mengstr/BEEPoo/README.md

## BEEPoo - Standalone AY3-8912 sound player

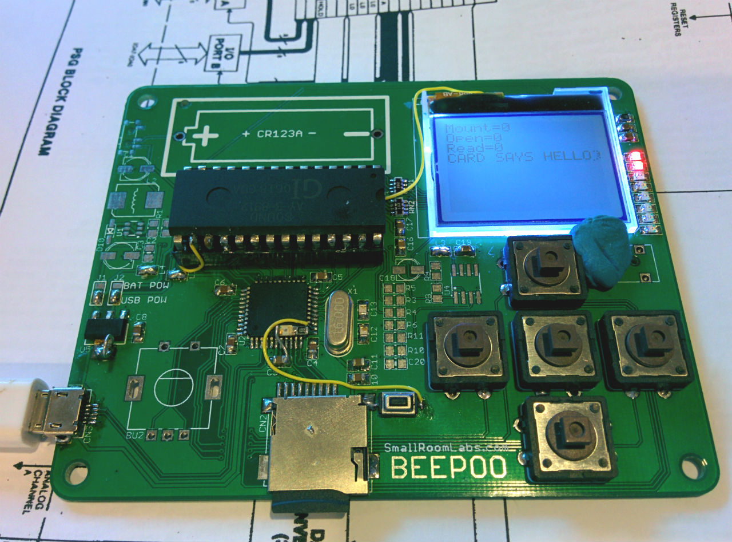
[picture p1: Misc/beepoo-devel1.jpg]
