mengstr/BEEPoo/Eagle/Beepoo.brd

## EAGLE design Eagle/Beepoo.brd (2014-11-11)

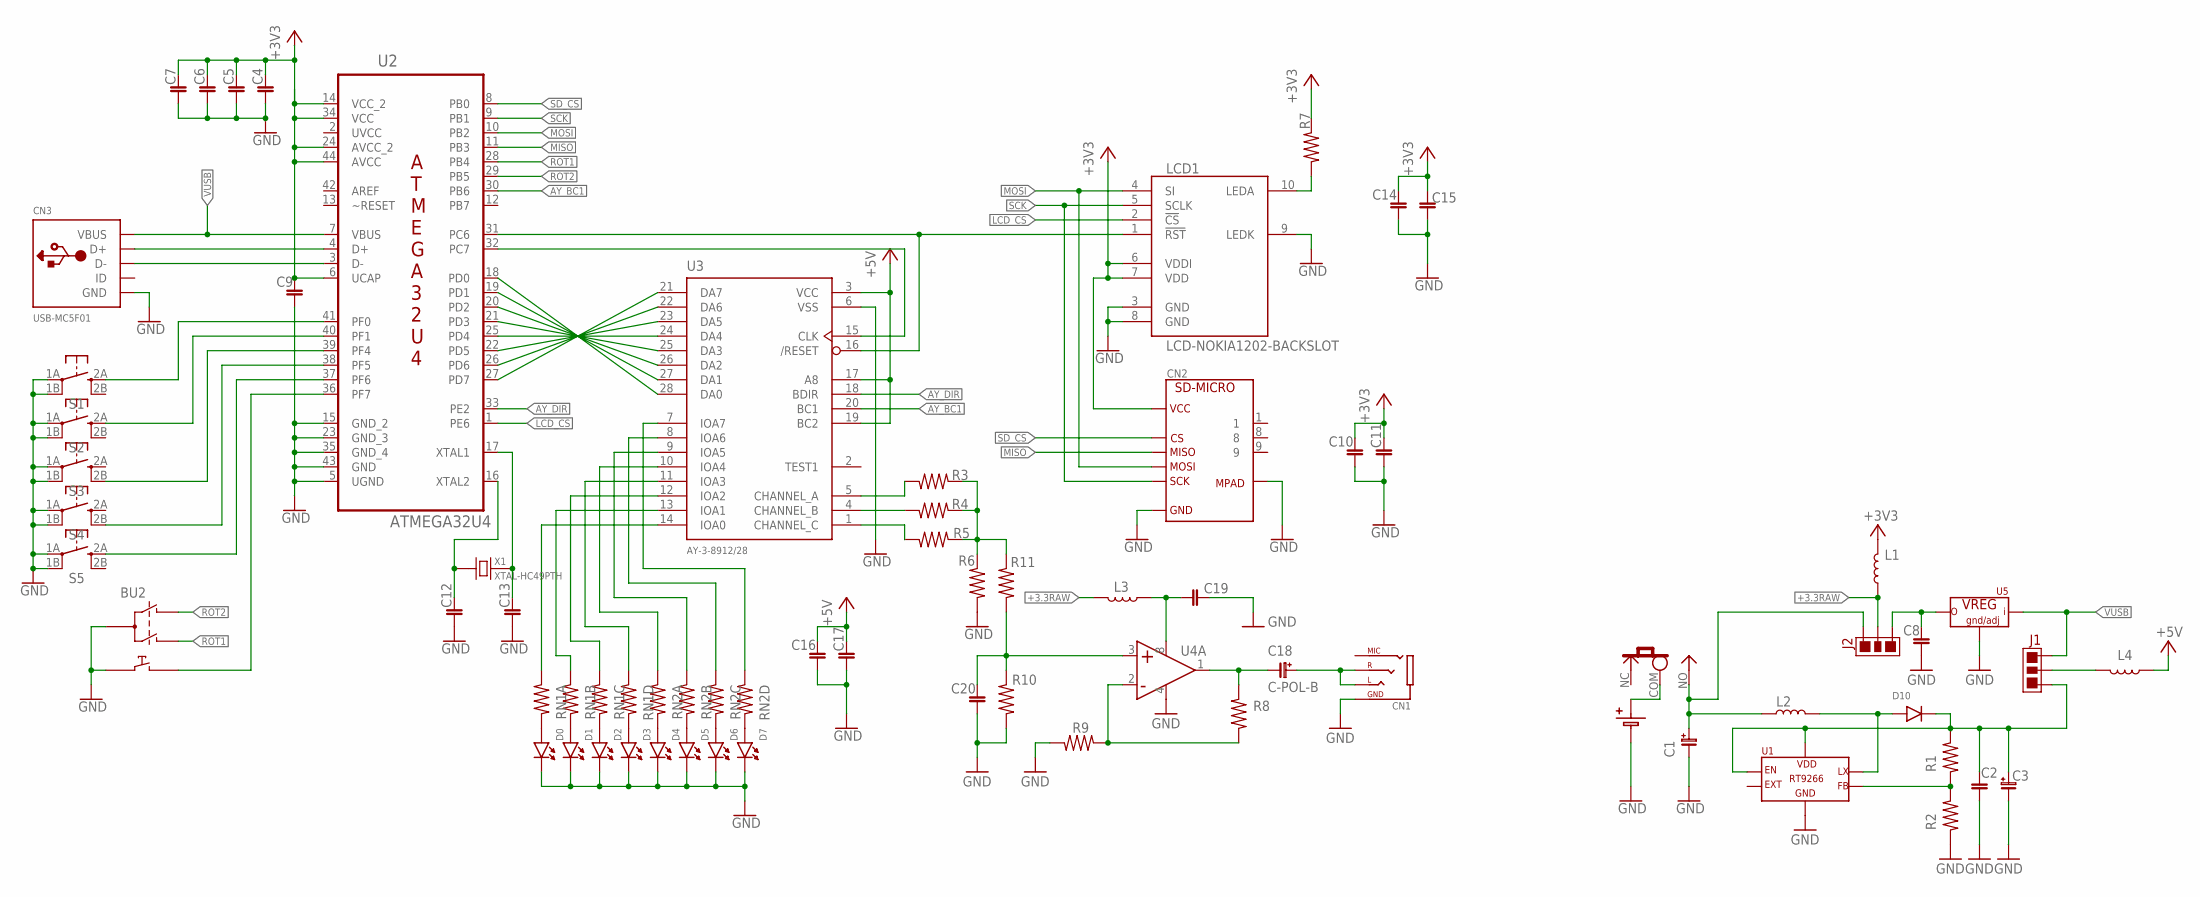
[picture p2: schematic Beepoo.sch]

Parts:
BA1: BATTERY2-CR123; BAT-CR123A
BU2: ROTARY
C1: C-POL-C; PANASONIC_C
C2, C4, C5, C6, C7, C11, C12, C13, C15, C17, C20: C-0805; C0805
C3: EEEFK0J101UR; PANASONIC_C
C8, C9, C10, C14, C16, C19: 1u; C0805
C18: C-POL-B; PANASONIC_B
CN1: JACK4PTH; PJ320E
CN2: SD-MICRO; SD-TFP09
CN3: USB-MC5F01; USB-MICRO-MC5F01
D0, D1, D2, D3, D4, D5, D6, D7: LED-0805; LED0805
D10: DIODE-SOD123; SOD123
J1, J2: JUMPER3-1.5MM; JP3-1.5MM
L1, L3, L4: L-0805; L0805
L2: L-BOURNS-SRP7030; IND-BOURNS-SRP7030
LCD1: LCD-NOKIA1202-BACKSLOT; NOKIA1202LCD-BACK-SLOT
R1, R2, R3, R4, R5, R6, R7, R8, R9, R10, R11: R-0805; R0805
RN1, RN2: R-ARR4; RN8P-4R-CRA06S
S1, S2, S3, S4, S5: SWITCH2-12X12PTH; TACT12X12-PTH
SW2: SLIDE1-PCM12; SW-PCM12
U1: RT9266-SOT23; SOT23-6
U2: ATMEGA32U4; TQFP44
U3: AY-3-8912/28; DIL28-6
U4: OPAMP-DUAL-SOIC8; SO08
U5: VREG3-SOT223; SOT223
X1: XTAL-HC49PTH; HC49US

Connections:
+3.3RAW: J2.P$2, L1.1, L3.2
+3V3: C4.2, C5.2, C6.2, C7.2, C9.2, C10.2, C11.2, C14.2, C15.2, CN2.4, L1.2, LCD1.6 (VDDI), LCD1.7 (VDD), R7.1, U2.6 (UCAP), U2.14 (VCC_2), U2.24 (AVCC_2), U2.34 (VCC), U2.44 (AVCC)
+5V: C16.2, C17.2, L4.1, U3.3 (VCC), U3.17 (A8), U3.19 (BC2)
AY_BC1: U2.30 (PB6), U3.20 (BC1)
AY_CLK: U2.32 (PC7), U3.15 (CLK)
AY_DIR: U2.33 (PE2), U3.18 (BDIR)
AY_RESET: LCD1.1 (!RST), U2.31 (PC6), U3.16 (/RESET)
BAT: BA1.POS (POS1), SW2.COM
BAT-SWITCHED: C1.+ (A), J2.P$1, L2.P$1, SW2.NO
GND: BA1.NEG, BU2.Q, BU2.SW1, C1.- (C), C2.2, C3.- (C), C4.1, C5.1, C6.1, C7.1, C8.1, C9.1, C10.1, C11.1, C12.1, C13.1, C14.1, C15.1, C16.1, C17.1, C19.2, C20.1, CN1.G (GND), CN2.GND@1, CN2.GND@2, CN3.P5 (GND), D0.C, D1.C, D2.C, D3.C, D4.C, D5.C, D6.C, D7.C, LCD1.3 (GND), LCD1.8 (GND), LCD1.9 (LEDK), R2.1, R6.2, R9.2, R10.2, S1.1A, S1.1B, S2.1A, S2.1B, S3.1A, S3.1B, S4.1A, S4.1B, S5.1A, S5.1B, U1.3 (GND), U2.5 (UGND), U2.15 (GND_2), U2.23 (GND_3), U2.35 (GND_4), U2.43 (GND), U3.6 (VSS), U4.4 (V-), U5.1 (G/A)
LCD_CS: LCD1.2 (!CS), U2.1 (PE6)
MISO: CN2.7, U2.11 (PB3)
MOSI: CN2.3, LCD1.4 (SI), U2.10 (PB2)
unnamed: D10.A, L2.P$2, U1.4 (LX)
unnamed: C18.+ (A), CN1.L, CN1.R
unnamed: R1.1, R2.2, U1.6 (FB)
unnamed: U2.27 (PD7), U3.21 (DA7)
unnamed: U2.26 (PD6), U3.22 (DA6)
unnamed: U2.22 (PD5), U3.23 (DA5)
unnamed: U2.25 (PD4), U3.24 (DA4)
unnamed: U2.21 (PD3), U3.25 (DA3)
unnamed: U2.20 (PD2), U3.26 (DA2)
unnamed: U2.19 (PD1), U3.27 (DA1)
unnamed: U2.18 (PD0), U3.28 (DA0)
unnamed: C8.2, J2.P$3, U5.2 (OUT), U5.4 (OUT)
unnamed: CN3.P3 (D+), U2.4 (D+)
unnamed: CN3.P2 (D-), U2.3 (D-)
unnamed: C2.1, C3.+ (A), D10.C, J1.P$3, R1.2, U1.1 (EN), U1.5 (VDD)
unnamed: D0.A, RN1.8
unnamed: D1.A, RN1.7
unnamed: D2.A, RN1.6
unnamed: D3.A, RN1.5
unnamed: D4.A, RN2.8
unnamed: C12.2, U2.16 (XTAL2), X1.1
unnamed: D5.A, RN2.7
unnamed: D7.A, RN2.5
unnamed: D6.A, RN2.6
unnamed: RN2.4, U3.7 (IOA7)
unnamed: RN2.3, U3.8 (IOA6)
unnamed: RN2.2, U3.9 (IOA5)
unnamed: RN2.1, U3.10 (IOA4)
unnamed: RN1.4, U3.11 (IOA3)
unnamed: RN1.3, U3.12 (IOA2)
unnamed: RN1.2, U3.13 (IOA1)
unnamed: RN1.1, U3.14 (IOA0)
unnamed: R3.2, U3.5 (CHANNEL_A)
unnamed: R4.2, U3.4 (CHANNEL_B)
unnamed: R5.2, U3.1 (CHANNEL_C)
unnamed: S1.2A, U2.41 (PF0)
unnamed: S2.2A, U2.40 (PF1)
unnamed: S3.2B, U2.39 (PF4)
unnamed: S4.2B, U2.38 (PF5)
unnamed: S5.2A, U2.37 (PF6)
unnamed: R3.1, R4.1, R5.1, R6.1, R11.1
unnamed: BU2.SW2, U2.36 (PF7)
unnamed: C13.2, U2.17 (XTAL1), X1.2
unnamed: LCD1.10 (LEDA), R7.2
unnamed: C18.- (C), R8.1, U4.1 (OUT)
unnamed: C19.1, L3.1, U4.8 (V+)
unnamed: R8.2, R9.1, U4.2 (NEG)
unnamed: J1.P$2, L4.2
unnamed: C20.2, R10.1, R11.2, U4.3 (POS)
ROT1: BU2.Q2, U2.28 (PB4)
ROT2: BU2.Q1, U2.29 (PB5)
SCK: CN2.5, LCD1.5 (SCLK), U2.9 (PB1)
SD_CS: CN2.2, U2.8 (PB0)
UVCC: U2.2 (UVCC)
VUSB: CN3.P1 (VBUS), J1.P$1, U2.7 (VBUS), U5.3 (IN)

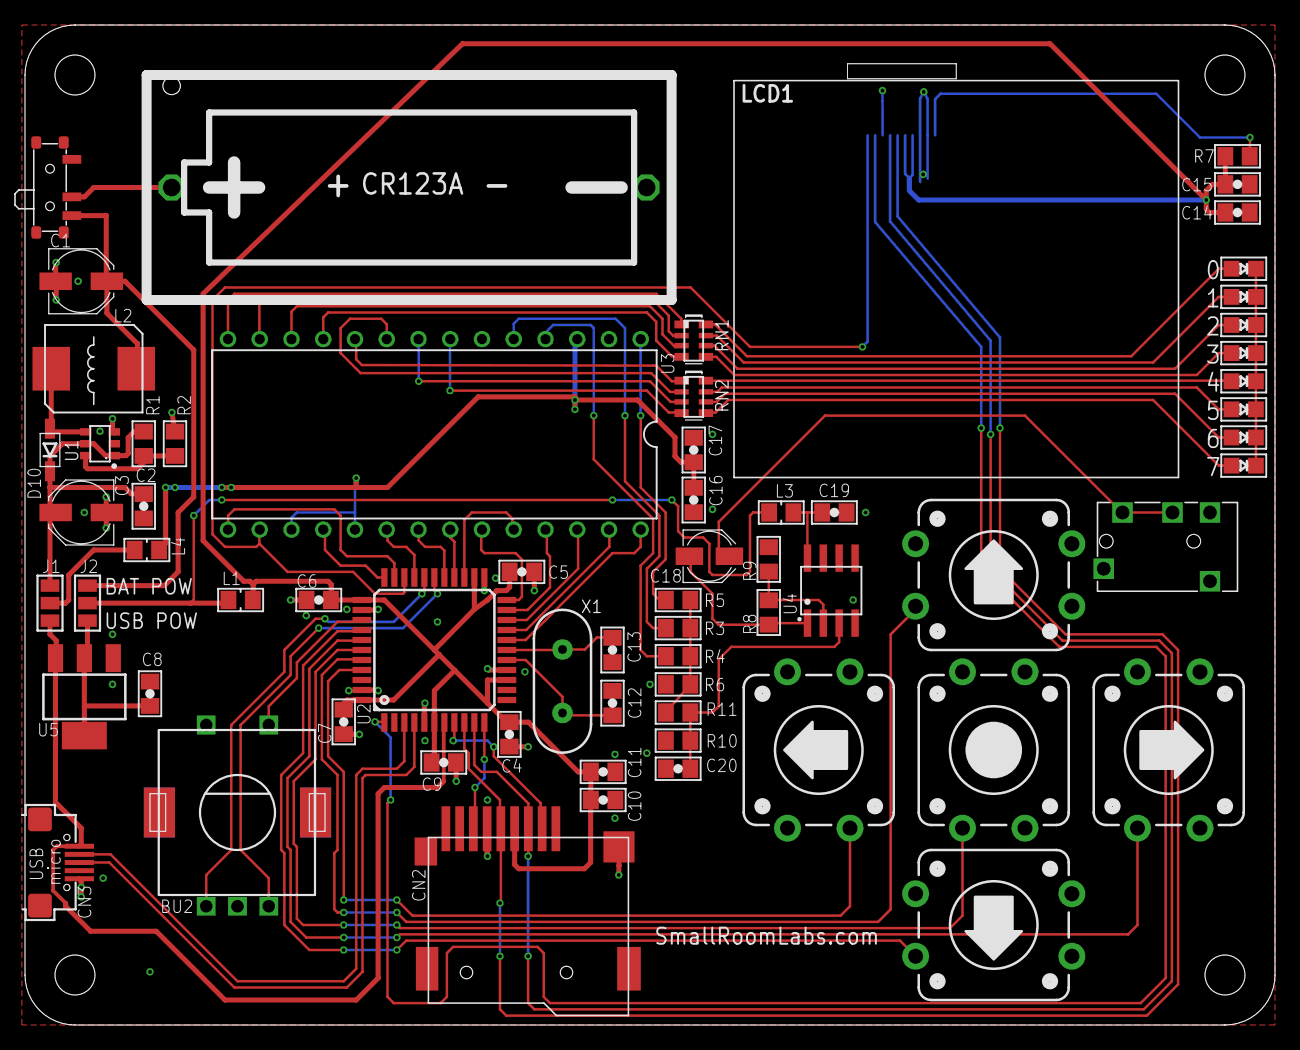
[picture p3: board Beepoo.brd from above]

Board: 2 copper layers, 100.0 x 80.0 mm, 66 parts (0 on the bottom side), 67 nets.
