mengstr/BEEPoo/Firmware/BEEPoo/BEEPoo.ino

//
// BEEPoo - Standalone AY-3-8912 player with ATMEGA32U4 with Arduino bootloader
//
// Copyright (c) 2014 SmallRoomLabs / Mats Engstrom - mats.engstrom@gmail.com
// 
// Hardware and Firmware released under the MIT License (MIT) than can be
// found in full in the file named LICENCE in the git repository.
//
// https://github.com/SmallRoomLabs/BEEPoo
//

//
//   PB0 SD_CS       RXLED
//   PB1 SCK         SCK
//   PB2 MOSI        MOSI
//   PB3 MISO        MISO
//   PB4 Rotary Q1   Digital pin 8  (PCINT4)
//   PB5 Rotary Q2   Digital Pin 9 (PCINT5) (PWM)
//   PB6 AY_BC1      Digital Pin 10 (PWM)
//   PB7             Digital pin 11 (PWM)
//   
//   PC6 AY_RESET#   Digital Pin 5 (PWM)
//   PC7 AY_CLK      Digital Pin 13 (PWM)
//   
//   PD0 AY_Data0    Digital pin 3 (SCL)(PWM)
//   PD1 AY_Data1    Digital pin 2 (SDA)
//   PD2 AY_Data2    Digital pin 0 (RX)
//   PD3 AY_Data3    Digital pin 1 (TX)
//   PD4 AY_Data4    Digital pin 4
//   PD5 AY_Data5    TXLED
//   PD6 AY_Data6    Digital pin 12
//   PD7 AY_Data7    Digital Pin 6 (PWM)
// 
//   PE2 AY_Dir      HWB
//   PE6 LCD_CS      Digital pin 7
//   
//   PF0 Button      Analog In 5
//   PF1 Button      Analog In 4
//   PF4 Button      Analog In 3
//   PF5 Button      Analog In 2
//   PF6 Button      Analog In 1
//   PF7 Rotary But  Analog In 0
// 
// 

#include <stdint.h>
#include "rotary.h"
#include "spi.h"
#include "timer1.h"
#include "timer4.h"
#include "ay38912.h"
#include "nokia1202.h"
#include "pff.h"
#include "selectFile.h"
#include "ymplayer.h"
#include "buttons.h"

int AY_RESET    = 5;        // D5
int AY_CLK      = 13;       // D13
int AY_BC1      = 10;       // D10
int DEBUG_LED   = 11;       // D11

#define DEBUGLED_ON  PORTB |= B10000000
#define DEBUGLED_OFF PORTB &= B01111111


//
//
//
void setup() {
  uint8_t mask;

  // PB0 o SD_CS       RXLED
  // PB1 o SCK         SCK
  // PB2 o MOSI        MOSI
  // PB3 i MISO        MISO
  // PB4 i Rotary Q1   Digital pin 8 
  // PB5 i Rotary Q2   Digital Pin 9 (PWM)
  // PB6 o AY_BC1      Digital Pin 10 (PWM)
  // PB7 o DEBUGLED    Digital pin 11 (PWM)
  DDRB=0x00 | (1<<0) | (1<<1) | (1<<2) | (1<<6) | (1<<7);
  // Enable pullup on Rotary Q1/Q3 & MISO
  PORTB=0x00 | (1<<3) | (1<<4) | (1<<5);  

  // PC6 o AY_RESET#   Digital Pin 5 (PWM)
  // PC7 o AY_CLK      Digital Pin 13 (PWM)
  DDRC=0x00 | (1<<6) | (1<<7);
  PORTC=0x00;

  // PD0 o AY_Data0    Digital pin 3 (SCL)(PWM)
  // PD1 o AY_Data1    Digital pin 2 (SDA)
  // PD2 o AY_Data2    Digital pin 0 (RX)
  // PD3 o AY_Data3    Digital pin 1 (TX)
  // PD4 o AY_Data4    Digital pin 4
  // PD5 o AY_Data5    TXLED
  // PD6 o AY_Data6    Digital pin 12
  // PD7 o AY_Data7    Digital Pin 6 (PWM)
  DDRD=0xFF;
  PORTD=0x00;

  // PE2 o AY_Dir      HWB
  // PE6 o LCD_CS      Digital pin 7
  DDRE=0x00 | (1<<2) | (1<<6);
  PORTE=0x00;  

  // PF0 i Button      Analog In 5
  // PF1 i Button      Analog In 4
  // PF4 i Button      Analog In 3
  // PF5 i Button      Analog In 2
  // PF6 i Button      Analog In 1
  // PF7 i Rotary But  Analog In 0
  DDRF=0x00;
  // Enable pullup on all Buttons & Rotary Button
  PORTF=0x00 | (1<<0) | (1<<1) | (1<<4) | (1<<5) | (1<<6) | (1<<7);  

  // Reset AY389-10
  digitalWrite(AY_RESET,LOW);

 // Start timer4 output to D13
  InitTimer4(1000000);
  SetTimer4Duty(512);
  Timer4Start();
  
  // Delay 1 ms before bringing AY out of reset
  delay(1);    
  digitalWrite(AY_RESET,HIGH);

  // Enable PORT A, and the thre tone channels on the AY-3-8912 
  // and turn off all leds
  AyRegister(AY_ENABLE,B01111000);
  for (mask=0x01; mask; mask*=2) {
    AyPort(mask);
    delay(25);
  }
  for (mask=0x40; mask; mask/=2) {
    AyPort(mask);
    delay(25);
  }
  AyPort(0x00); 

  // Turn on interrupts for Rotary Encoder
  PCMSK0 |= (1<<PCINT4) | (1<<PCINT5);      //enable encoder pins interrupt sources
  EICRB |= (1<<ISC40) | (1<<ISC50);
  PCICR |= ( 1<<PCIE0 );

  InitTimer1(64286);  

  DEBUGLED_ON;
}



//
// Handle the 50Hz timer1 interrupt
//
ISR(TIMER1_OVF_vect) {
  IrqTimer1();
}


//
// Currently we only have one interrupt source
// so we can assume it's a rotary encoder interrupt
//
ISR(PCINT0_vect) {
  IrqRotaryEncoder();
}









FATFS  fs;


//
//
//
void loop() {
  int res;
  int i;
  char filename[32];

  LcdInit();

  LcdXY(0,0);LcdString("Mount=");
  res=pf_mount(&fs);
  LcdCharacter(48+res);
  delay(500);

  SelectFile(filename);
  LcdClear();
  LcdString(filename);
  YmPlay(filename);

  DEBUGLED_OFF;
  for (;;) {
      delay(1);
      AyPort(rotaryValue);
      AyRegister(AY_CH_A_FINETUNE, rand()&0xFF);
//      AyRegister(AY_CH_A_COARSETUNE, 1);
  }
}
