mengstr/BEEPoo/Firmware/BEEPoo/sd.h

// #ifndef SD_H_
// #define SD_H_

// #include <stdint.h>
// #ifdef __cplusplus
// extern "C" {
// #endif

// char SdInit(void);
// void SdRead(uint32_t sector, uint16_t offset, uint8_t *buffer, uint16_t len);


// #ifdef __cplusplus
// }
// #endif

// #endif
