mengstr/BEEPoo/(commit log)

2014-11-11 Add reset to LCD. Connect A8 of AY to VCC
    [Beepoo.brd, Beepoo.sch]
2014-11-11 Add image of devel board
2014-11-12 Add rotary encoder irq handler
